inopya/CanSat_demo/(list of files, drawings)

Other design files:
cansatDemo_inopya.fzz
